rikiguan/oscilloscope_GD32/assets/2024-07-31-13-42-51-image.png

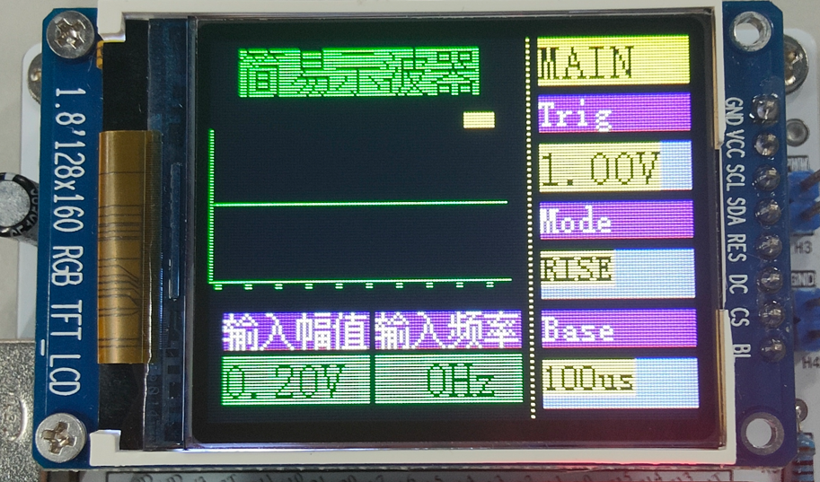
assets/2024-07-31-13-42-51-image.png
