rikiguan/oscilloscope_GD32/assets/2024-07-31-14-30-22-image.png

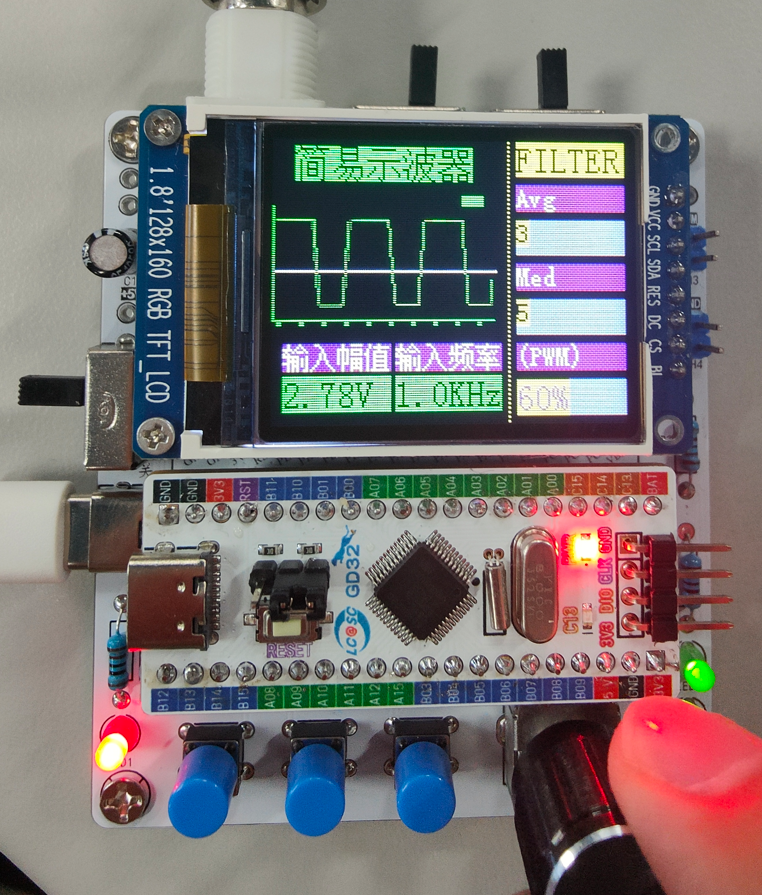
assets/2024-07-31-14-30-22-image.png
