rikiguan/oscilloscope_GD32/Hardware/FREQ/freq.c

#include "freq.h"
#include "main.h"
#include "update.h"

void Init_FreqTimer(void)
{
    //定时器通道输入参数结构体
    timer_ic_parameter_struct timer_icinitpara;
    
    //定时器参数结构体
    timer_parameter_struct timer_initpara;
    
    //使能时钟
    rcu_periph_clock_enable(RCU_GPIOA);
    rcu_periph_clock_enable(RCU_TIMER2);
    
    //设置引脚模式
    gpio_mode_set(GPIOA, GPIO_MODE_AF, GPIO_PUPD_NONE, GPIO_PIN_6);
    
    //设置输出状态
    gpio_output_options_set(GPIOA, GPIO_OTYPE_PP, GPIO_OSPEED_50MHZ,GPIO_PIN_6);
    
    //设置为复用功能
    gpio_af_set(GPIOA, GPIO_AF_1, GPIO_PIN_6);
    
    //定时器中断使能
    nvic_irq_enable(TIMER2_IRQn, 2U);
    
    //复位定时器
    timer_deinit(TIMER2);
    
    //定时器参数初始化
    timer_struct_para_init(&timer_initpara);
    
    timer_initpara.prescaler         = 0;                  //预分频器参数
    timer_initpara.alignedmode       = TIMER_COUNTER_EDGE;  //边沿对齐
    timer_initpara.counterdirection  = TIMER_COUNTER_UP;    //向上计数
    timer_initpara.period            = 65535;               //周期
    timer_initpara.clockdivision     = TIMER_CKDIV_DIV1;    //时钟分频
    timer_init(TIMER2, &timer_initpara);                    //参数初始化
    
    //定时器通道输入参数初始化
    timer_channel_input_struct_para_init(&timer_icinitpara);
    
    timer_icinitpara.icpolarity  = TIMER_IC_POLARITY_RISING;        //通道输入极性
    timer_icinitpara.icselection = TIMER_IC_SELECTION_DIRECTTI;     //通道输入模式选择
    timer_icinitpara.icprescaler = TIMER_IC_PSC_DIV1;               //通道输入捕获预分频
    timer_icinitpara.icfilter    = 0x00;                             //通道输入捕获滤波
    timer_input_capture_config(TIMER2,TIMER_CH_0,&timer_icinitpara);
    
    //使能自动重装载值
    timer_auto_reload_shadow_enable(TIMER2);
    
    //清除中断标志位
    timer_interrupt_flag_clear(TIMER2,TIMER_INT_FLAG_CH0);
    
    //使能定时器通道中断
    timer_interrupt_enable(TIMER2,TIMER_INT_CH0);
		timer_interrupt_enable(TIMER2, TIMER_INT_UP);
    
    //定时器中断使能
    timer_enable(TIMER2);
}
static __IO uint32_t Value = 0;
static __IO uint8_t ccnumber = 0;
static __IO uint32_t freq = 0;
static __IO uint32_t freqPeriod = 0;
static __IO uint16_t readvalue1 = 0, readvalue2 = 0;


extern volatile struct Oscilloscope oscilloscope;


#define TIMER_FREQUENCY 72000000U //(1 MHz)


#define WINDOW_SIZE 5
volatile uint32_t captureValues[WINDOW_SIZE];
uint8_t captureIndex = 0;
uint32_t avgDiff=10000;
void TIMER2_IRQHandler(void)
{
  if(timer_interrupt_flag_get(TIMER2, TIMER_INT_FLAG_CH0)!= RESET)
  {
      
      if(0 == ccnumber){
            // 读第一次通道0捕获值
            readvalue1 = timer_channel_capture_value_register_read(TIMER2, TIMER_CH_0);
            ccnumber = 1;
						freqPeriod=0;
        }else if(1 == ccnumber){
            // 读第2次通道0捕获值 
            readvalue2 = timer_channel_capture_value_register_read(TIMER2, TIMER_CH_0);
						Value = ((0xFFFFU*freqPeriod - readvalue1) + readvalue2);
						//printf("%d\n",Value);
						
						avgFilter(Value, (uint32_t *)captureValues, (uint8_t *)&captureIndex, (uint32_t *)&avgDiff, WINDOW_SIZE);
						freq = TIMER_FREQUENCY/((uint32_t)TIMER_PSC(TIMER2)+1) / avgDiff;
						//printf("%d\n",avgDiff);
						//printf("%d\n",freq);
						oscilloscope.gatherFreq = freq;						
						ccnumber = 0;							
									
        }
        timer_interrupt_flag_clear(TIMER2, TIMER_INT_FLAG_CH0);
  }
	  if (timer_interrupt_flag_get(TIMER2, TIMER_INT_FLAG_UP) != RESET) {
        timer_interrupt_flag_clear(TIMER2, TIMER_INT_FLAG_UP);
        freqPeriod++;
    }
}
