rikiguan/oscilloscope_GD32/(commit log)

2024-07-26 add medium filter
2024-07-26 add freq filter
2024-07-26 add adc trigger
2024-07-27 add pwm_measure
